KadhirTheEngineer/kaboardv3/documentation/image-2.png

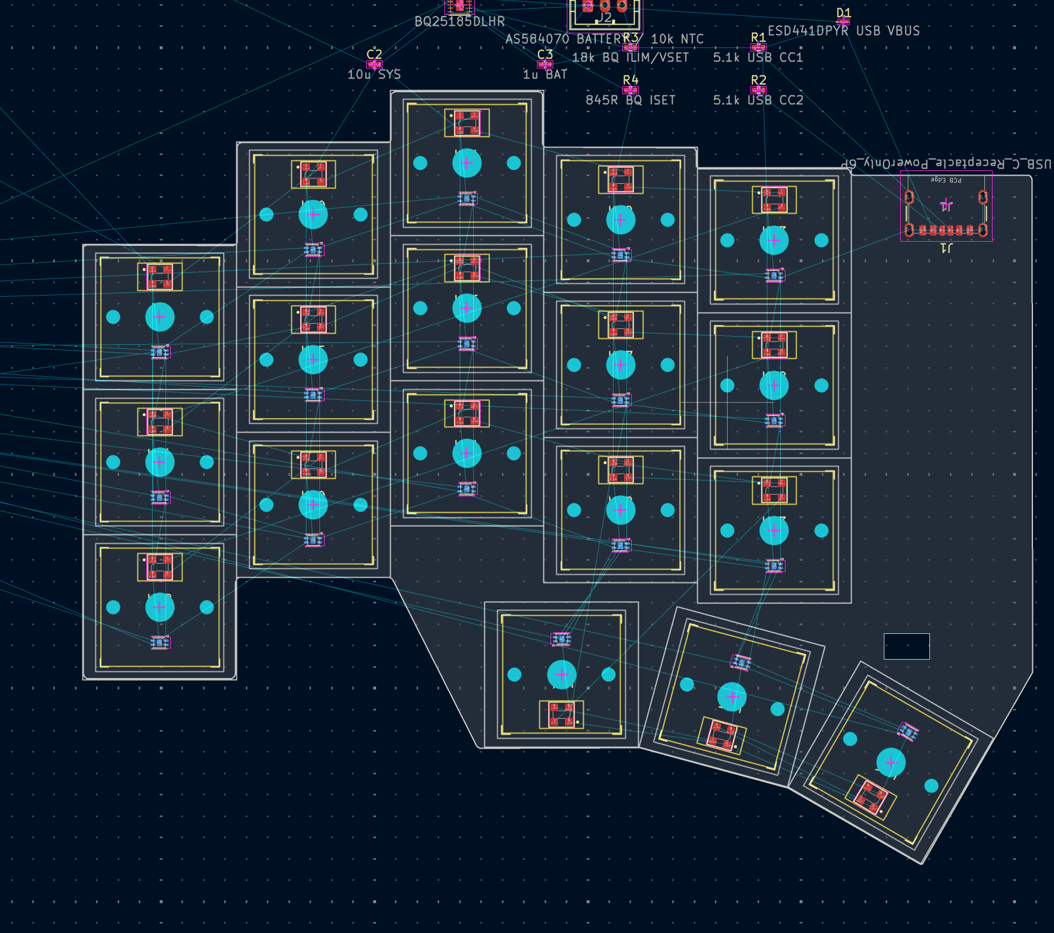
documentation/image-2.png
