KadhirTheEngineer/kaboardv3/receiver/kaboard-receiver.kicad_pcb

## KiCad design receiver/kaboard-receiver.kicad_pcb (2026-09-09)

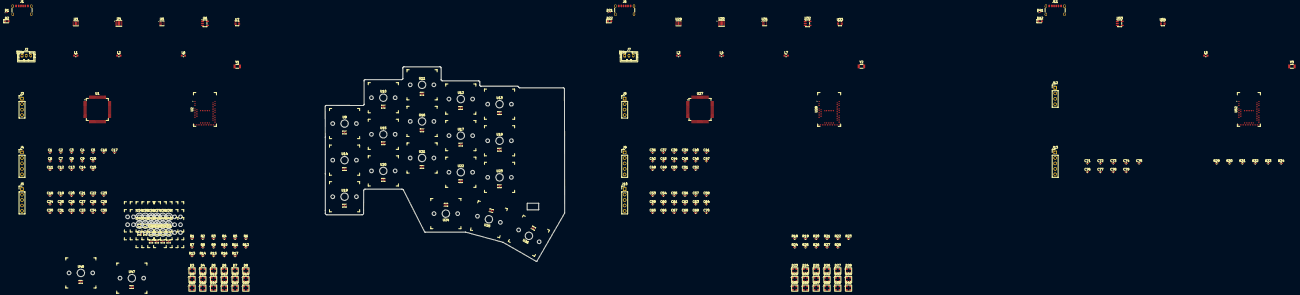
[picture p4: board kaboard-receiver.kicad_pcb from above]

Board: 2 copper layers, 231 parts (0 on the bottom side), 178 nets, no tracks yet.

Parts:
C1, C36: 1u BQ IN; C_0402_1005Metric
C2, C37: 10u SYS; C_0402_1005Metric
C3, C38: 1u BAT; C_0402_1005Metric
C4, C39: 10u TPS IN; C_0402_1005Metric
C5, C40: 10u 3V3; C_0402_1005Metric
C6, C41: 100n STM VDD; C_0402_1005Metric
C7, C42: 100n STM VDDA; C_0402_1005Metric
C8, C43, C73: 100n nRF VDD; C_0402_1005Metric
C9, C44, C74: 100n nRF VDDH; C_0402_1005Metric
C10, C45, C75: 100n nRF VBUS; C_0402_1005Metric
C11, C46, C76: 12p NRF XL1; C_0402_1005Metric
C12, C47, C77: 12p NRF XL2; C_0402_1005Metric
C13, C48: 10u RGB IN; C_0402_1005Metric
C14, C49: 47u LED 5V; C_0402_1005Metric
C15, C50: 100n LED bulk; C_0402_1005Metric
C16, C51, C78: 1u OLED VCC; C_0402_1005Metric
C17, C52, C79: 100n OLED VCC; C_0402_1005Metric
C18: 100n TMAG A01; C_0402_1005Metric
C19: 100n TMAG A02; C_0402_1005Metric
C20: 100n TMAG A03; C_0402_1005Metric
C21: 100n TMAG A04; C_0402_1005Metric
C22: 100n TMAG A05; C_0402_1005Metric
C23: 100n TMAG A06; C_0402_1005Metric
C24: 100n TMAG A07; C_0402_1005Metric
C25: 100n TMAG A08; C_0402_1005Metric
C26: 100n TMAG A09; C_0402_1005Metric
C27: 100n TMAG A10; C_0402_1005Metric
C28: 100n TMAG A11; C_0402_1005Metric
C29: 100n TMAG A12; C_0402_1005Metric
C30: 100n TMAG A13; C_0402_1005Metric
C31: 100n TMAG A14; C_0402_1005Metric
C32: 100n TMAG A15; C_0402_1005Metric
C33: 100n TMAG A16; C_0402_1005Metric
C34: 100n TMAG A17; C_0402_1005Metric
C35: 100n TMAG A18; C_0402_1005Metric
C53: 100n TMAG B01; C_0402_1005Metric
C54: 100n TMAG B02; C_0402_1005Metric
C55: 100n TMAG B03; C_0402_1005Metric
C56: 100n TMAG B04; C_0402_1005Metric
C57: 100n TMAG B05; C_0402_1005Metric
C58: 100n TMAG B06; C_0402_1005Metric
C59: 100n TMAG B07; C_0402_1005Metric
C60: 100n TMAG B08; C_0402_1005Metric
C61: 100n TMAG B09; C_0402_1005Metric
C62: 100n TMAG B10; C_0402_1005Metric
C63: 100n TMAG B11; C_0402_1005Metric
C64: 100n TMAG B12; C_0402_1005Metric
C65: 100n TMAG B13; C_0402_1005Metric
C66: 100n TMAG B14; C_0402_1005Metric
C67: 100n TMAG B15; C_0402_1005Metric
C68: 100n TMAG B16; C_0402_1005Metric
C69: 100n TMAG B17; C_0402_1005Metric
C70: 100n TMAG B18; C_0402_1005Metric
C71: 10u USB 5V IN; C_0402_1005Metric
C72: 10u RX 3V3; C_0402_1005Metric
D1, D21, D41: ESD441DPYR USB VBUS; D_0201_0603Metric
D2: LEFT STATUS LED; LED_0603_1608Metric
D3: WL-ICLED A01; U_Wurth_WL-ICLED_1312020030000
D4: WL-ICLED A02; U_Wurth_WL-ICLED_1312020030000
D5: WL-ICLED A03; U_Wurth_WL-ICLED_1312020030000
D6: WL-ICLED A04; U_Wurth_WL-ICLED_1312020030000
D7: WL-ICLED A05; U_Wurth_WL-ICLED_1312020030000
D8: WL-ICLED A06; U_Wurth_WL-ICLED_1312020030000
D9: WL-ICLED A07; U_Wurth_WL-ICLED_1312020030000
D10: WL-ICLED A08; U_Wurth_WL-ICLED_1312020030000
D11: WL-ICLED A09; U_Wurth_WL-ICLED_1312020030000
D12: WL-ICLED A10; U_Wurth_WL-ICLED_1312020030000
D13: WL-ICLED A11; U_Wurth_WL-ICLED_1312020030000
D14: WL-ICLED A12; U_Wurth_WL-ICLED_1312020030000
D15: WL-ICLED A13; U_Wurth_WL-ICLED_1312020030000
D16: WL-ICLED A14; U_Wurth_WL-ICLED_1312020030000
D17: WL-ICLED A15; U_Wurth_WL-ICLED_1312020030000
D18: WL-ICLED A16; U_Wurth_WL-ICLED_1312020030000
D19: WL-ICLED A17; U_Wurth_WL-ICLED_1312020030000
D20: WL-ICLED A18; U_Wurth_WL-ICLED_1312020030000
D22: RIGHT STATUS LED; LED_0603_1608Metric
D23: WL-ICLED B01; U_Wurth_WL-ICLED_1312020030000
D24: WL-ICLED B02; U_Wurth_WL-ICLED_1312020030000
D25: WL-ICLED B03; U_Wurth_WL-ICLED_1312020030000
D26: WL-ICLED B04; U_Wurth_WL-ICLED_1312020030000
D27: WL-ICLED B05; U_Wurth_WL-ICLED_1312020030000
D28: WL-ICLED B06; U_Wurth_WL-ICLED_1312020030000
D29: WL-ICLED B07; U_Wurth_WL-ICLED_1312020030000
D30: WL-ICLED B08; U_Wurth_WL-ICLED_1312020030000
D31: WL-ICLED B09; U_Wurth_WL-ICLED_1312020030000
D32: WL-ICLED B10; U_Wurth_WL-ICLED_1312020030000
D33: WL-ICLED B11; U_Wurth_WL-ICLED_1312020030000
D34: WL-ICLED B12; U_Wurth_WL-ICLED_1312020030000
D35: WL-ICLED B13; U_Wurth_WL-ICLED_1312020030000
D36: WL-ICLED B14; U_Wurth_WL-ICLED_1312020030000
D37: WL-ICLED B15; U_Wurth_WL-ICLED_1312020030000
D38: WL-ICLED B16; U_Wurth_WL-ICLED_1312020030000
D39: WL-ICLED B17; U_Wurth_WL-ICLED_1312020030000
D40: WL-ICLED B18; U_Wurth_WL-ICLED_1312020030000
D42: STATUS LED; LED_0603_1608Metric
J1, J6, J11: USB_C_Receptacle_PowerOnly_6P; USB_C_Receptacle_GCT_USB4125-xx-x-0190_6P_TopMnt_Horizontal
J2, J7: AS584070 BATTERY / 10k NTC; JST_PH_B3B-PH-K_1x03_P2.00mm_Vertical
J3, J8, J12: SH1106 1.3in 4-wire OLED; PinHeader_1x04_P2.54mm_Vertical
J4, J9: STM32 SWD; PinHeader_1x05_P2.54mm_Vertical
J5, J10: nRF SWD; PinHeader_1x05_P2.54mm_Vertical
J13: Receiver nRF SWD; PinHeader_1x05_P2.54mm_Vertical
L1, L3: 2.2uH TPS63031; L_0603_1608Metric
L2, L4: 1uH RGB BOOST; L_0603_1608Metric
L5, L6, L7: 10uH nRF DCDC; L_0603_1608Metric
R1, R15, R29: 5.1k USB CC1; R_0402_1005Metric
R2, R16, R30: 5.1k USB CC2; R_0402_1005Metric
R3, R17: 18k BQ ILIM/VSET; R_0402_1005Metric
R4, R18: 845R BQ ISET; R_0402_1005Metric
R5, R19, R31: 10k nRF RESET pullup; R_0402_1005Metric
R6, R20: 10k BOOT0 pulldown; R_0402_1005Metric
R7, R21, R32: 4.7k I2C SDA pullup; R_0402_1005Metric
R8, R22, R33: 4.7k I2C SCL pullup; R_0402_1005Metric
R9, R23: 1M BAT_SENSE top; R_0402_1005Metric
R10, R24: 330k BAT_SENSE bottom; R_0402_1005Metric
R11, R25: 330R RGB data; R_0402_1005Metric
R12, R26: 732k RGB FB top; R_0402_1005Metric
R13, R27: 100k RGB FB bottom; R_0402_1005Metric
R14, R28, R34: 1k STATUS LED; R_0402_1005Metric
U1, U27: STM32G431RBTx; LQFP-64_10x10mm_P0.5mm
U2, U28, U52: MDBT50Q-1MV2; Raytac_MDBT50Q
U3, U29: BQ25185DLHR; Texas_DLH0010A_WSON-10-1EP_2.2x2mm_P0.4mm_EP0.9x1.5mm
U4, U30: TPS63031DSK; WSON-10-1EP_2.5x2.5mm_P0.5mm_EP1.2x2mm
U5, U31: TPS61022 RGB BOOST; Texas_RWU0007A_VQFN-7_2x2mm_P0.5mm
U6, U32: 74AHCT1G125; SOT-23-5
U7, U33, U54: TPS22919DCK; SOT-363_SC-70-6
U9: TMAG5253 A01; Kaboard_JadePro_TMAG5253
U10: TMAG5253 A02; Kaboard_JadePro_TMAG5253
U11: TMAG5253 A03; Kaboard_JadePro_TMAG5253
U12: TMAG5253 A04; Kaboard_JadePro_TMAG5253
U13: TMAG5253 A05; Kaboard_JadePro_TMAG5253
U14: TMAG5253 A06; Kaboard_JadePro_TMAG5253
U15: TMAG5253 A07; Kaboard_JadePro_TMAG5253
U16: TMAG5253 A08; Kaboard_JadePro_TMAG5253
U17: TMAG5253 A09; Kaboard_JadePro_TMAG5253
U18: TMAG5253 A10; Kaboard_JadePro_TMAG5253
U19: TMAG5253 A11; Kaboard_JadePro_TMAG5253
U20: TMAG5253 A12; Kaboard_JadePro_TMAG5253
U21: TMAG5253 A13; Kaboard_JadePro_TMAG5253
U22: TMAG5253 A14; Kaboard_JadePro_TMAG5253
U23: TMAG5253 A15; Kaboard_JadePro_TMAG5253
U24: TMAG5253 A16; Kaboard_JadePro_TMAG5253
U25: TMAG5253 A17; Kaboard_JadePro_TMAG5253
U26: TMAG5253 A18; Kaboard_JadePro_TMAG5253
U34: TMAG5253 B01; Kaboard_JadePro_TMAG5253
U35: TMAG5253 B02; Kaboard_JadePro_TMAG5253
U36: TMAG5253 B03; Kaboard_JadePro_TMAG5253
U37: TMAG5253 B04; Kaboard_JadePro_TMAG5253
U38: TMAG5253 B05; Kaboard_JadePro_TMAG5253
U39: TMAG5253 B06; Kaboard_JadePro_TMAG5253
U40: TMAG5253 B07; Kaboard_JadePro_TMAG5253
U41: TMAG5253 B08; Kaboard_JadePro_TMAG5253
U42: TMAG5253 B09; Kaboard_JadePro_TMAG5253
U43: TMAG5253 B10; Kaboard_JadePro_TMAG5253
U44: TMAG5253 B11; Kaboard_JadePro_TMAG5253
U45: TMAG5253 B12; Kaboard_JadePro_TMAG5253
U46: TMAG5253 B13; Kaboard_JadePro_TMAG5253
U47: TMAG5253 B14; Kaboard_JadePro_TMAG5253
U48: TMAG5253 B15; Kaboard_JadePro_TMAG5253
U49: TMAG5253 B16; Kaboard_JadePro_TMAG5253
U50: TMAG5253 B17; Kaboard_JadePro_TMAG5253
U51: TMAG5253 B18; Kaboard_JadePro_TMAG5253
U53: AP2112K-3.3; SOT-23-5
Y1, Y2, Y3: 32.768kHz; Crystal_SMD_3215-2Pin_3.2x1.5mm

Connections:
/L_3V3: C5.1, C6.1, C7.1, C8.1, C9.1, C10.1, C13.1, C18.1, C19.1, C20.1, C21.1, C22.1, C23.1, C24.1, C25.1, C26.1, C27.1, C28.1, C29.1, C30.1, C31.1, C32.1, C33.1, C34.1, C35.1, J4.1, J5.1, L2.1, L6.2, R5.2, R7.1, R8.1, U1.1 (VBAT), U1.16 (VDD), U1.28 (VREF+), U1.29 (VDDA), U1.32 (VDD), U1.48 (VDD), U1.64 (VDD), U2.28 (VDD), U2.30 (VDDH), U2.32 (VBUS), U4.1 (VOUT), U4.10 (FB), U5.7 (VIN), U7.1 (IN), U9.1 (VCC), U10.1 (VCC), U11.1 (VCC), U12.1 (VCC), U13.1 (VCC), U14.1 (VCC), U15.1 (VCC), U16.1 (VCC), U17.1 (VCC), U18.1 (VCC), U19.1 (VCC), U20.1 (VCC), U21.1 (VCC), U22.1 (VCC), U23.1 (VCC), U24.1 (VCC), U25.1 (VCC), U26.1 (VCC)
/L_BAT: C3.1, J2.1, R9.1, U3.2 (BAT)
/L_BAT_SENSE: R9.2, R10.1, U2.10 (P0.29)
/L_BOOT0: R6.1, U1.61 (PB8)
/L_BQ_ILIM: R3.1, U3.7 (ILIM/VSET)
/L_BQ_ISET: R4.1, U3.8 (ISET)
/L_DISPLAY_EN: U2.49 (P0.25), U7.3 (ON)
/L_DISPLAY_SCL: J3.3, R8.2, U2.19 (P0.26)
/L_DISPLAY_SDA: J3.4, R7.2, U2.16 (P0.27)
/L_GND: C1.2, C2.2, C3.2, C4.2, C5.2, C6.2, C7.2, C8.2, C9.2, C10.2, C11.2, C12.2, C13.2, C14.2, C15.2, C16.2, C17.2, C18.2, C19.2, C20.2, C21.2, C22.2, C23.2, C24.2, C25.2, C26.2, C27.2, C28.2, C29.2, C30.2, C31.2, C32.2, C33.2, C34.2, C35.2, D1.2 (GND), D2.1 (K), D3.4 (VSS), D4.4 (VSS), D5.4 (VSS), D6.4 (VSS), D7.4 (VSS), D8.4 (VSS), D9.4 (VSS), D10.4 (VSS), D11.4 (VSS), D12.4 (VSS), D13.4 (VSS), D14.4 (VSS), D15.4 (VSS), D16.4 (VSS), D17.4 (VSS), D18.4 (VSS), D19.4 (VSS), D20.4 (VSS), J1.A12 (GND), J1.B12 (GND), J1.SH (SHIELD), J2.3, J3.2, J4.2, J5.2, R1.2, R2.2, R3.2, R4.2, R6.2, R10.2, R13.2, U1.15 (VSS), U1.27 (VSSA), U1.31 (VSS), U1.47 (VSS), U1.63 (VSS), U2.1 (GND), U2.2 (GND), U2.15 (GND), U2.33 (GND), U2.55 (GND), U3.4 (/CE), U3.5 (GND), U3.11 (EP), U4.3 (PGND), U4.7 (PS/SYNC), U4.9 (GND), U4.11 (PGND), U5.1 (GND), U5.6 (MODE), U6.1, U6.3 (GND), U7.2 (GND), U9.2 (GND), U9.5 (EP), U10.2 (GND), U10.5 (EP), U11.2 (GND), U11.5 (EP), U12.2 (GND), U12.5 (EP), U13.2 (GND), U13.5 (EP), U14.2 (GND), U14.5 (EP), U15.2 (GND), U15.5 (EP), U16.2 (GND), U16.5 (EP), U17.2 (GND), U17.5 (EP), U18.2 (GND), U18.5 (EP), U19.2 (GND), U19.5 (EP), U20.2 (GND), U20.5 (EP), U21.2 (GND), U21.5 (EP), U22.2 (GND), U22.5 (EP), U23.2 (GND), U23.5 (EP), U24.2 (GND), U24.5 (EP), U25.2 (GND), U25.5 (EP), U26.2 (GND), U26.5 (EP)
/L_HALL_EN_A: U1.38 (PC6), U9.3 (EN), U10.3 (EN), U11.3 (EN), U12.3 (EN), U13.3 (EN), U14.3 (EN)
/L_HALL_EN_B: U1.39 (PC7), U15.3 (EN), U16.3 (EN), U17.3 (EN), U18.3 (EN), U19.3 (EN), U20.3 (EN)
/L_HALL_EN_C: U1.40 (PC8), U21.3 (EN), U22.3 (EN), U23.3 (EN), U24.3 (EN), U25.3 (EN), U26.3 (EN)
/L_HALL_OUT_01: U1.8 (PC0), U9.4 (OUT)
/L_HALL_OUT_02: U1.9 (PC1), U10.4 (OUT)
/L_HALL_OUT_03: U1.10 (PC2), U11.4 (OUT)
/L_HALL_OUT_04: U1.11 (PC3), U12.4 (OUT)
/L_HALL_OUT_05: U1.12 (PA0), U13.4 (OUT)
/L_HALL_OUT_06: U1.13 (PA1), U14.4 (OUT)
/L_HALL_OUT_07: U1.14 (PA2), U15.4 (OUT)
/L_HALL_OUT_08: U1.17 (PA3), U16.4 (OUT)
/L_HALL_OUT_09: U1.18 (PA4), U17.4 (OUT)
/L_HALL_OUT_10: U1.19 (PA5), U18.4 (OUT)
/L_HALL_OUT_11: U1.20 (PA6), U19.4 (OUT)
/L_HALL_OUT_12: U1.21 (PA7), U20.4 (OUT)
/L_HALL_OUT_13: U1.22 (PC4), U21.4 (OUT)
/L_HALL_OUT_14: U1.23 (PC5), U22.4 (OUT)
/L_HALL_OUT_15: U1.24 (PB0), U23.4 (OUT)
/L_HALL_OUT_16: U1.25 (PB1), U24.4 (OUT)
/L_HALL_OUT_17: U1.26 (PB2), U25.4 (OUT)
/L_HALL_OUT_18: U1.33 (PB11), U26.4 (OUT)
/L_LED_5V: C14.1, C15.1, D3.1 (VDD), D4.1 (VDD), D5.1 (VDD), D6.1 (VDD), D7.1 (VDD), D8.1 (VDD), D9.1 (VDD), D10.1 (VDD), D11.1 (VDD), D12.1 (VDD), D13.1 (VDD), D14.1 (VDD), D15.1 (VDD), D16.1 (VDD), D17.1 (VDD), D18.1 (VDD), D19.1 (VDD), D20.1 (VDD), R12.1, U5.3 (VOUT), U5.4 (FB), U6.5 (VCC)
/L_NRF_DCCH: L6.1, U2.31 (DCCH)
/L_NRF_RESET_N: J5.5, R5.1, U2.40 (P0.18)
/L_NRF_XL1: C11.1, U2.17 (P0.00), Y1.1
/L_NRF_XL2: C12.1, U2.18 (P0.01), Y1.2
/L_NTC: J2.2, U3.6 (TS/MR)
/L_OLED_VCC: C16.1, C17.1, J3.1, U7.6 (OUT)
/L_RGB_DATA_3V3: U1.42 (PA8), U6.2
/L_RGB_DATA_5V: R11.1, U6.4
/L_RGB_DIN_01: D3.2 (DIN), R11.2
/L_RGB_DIN_07: D8.3 (DOUT), D9.2 (DIN)
/L_RGB_DIN_13: D14.3 (DOUT), D15.2 (DIN)
/L_RGB_FB: R12.2, R13.1
/L_RGB_PWR_EN: U1.43 (PA9), U5.5 (EN)
/L_RGB_SW: L2.2, U5.2 (SW)
/L_SPI_CS_N: U1.51 (PA15), U2.44 (P0.20)
/L_SPI_MISO: U1.53 (PC11), U2.46 (P0.22)
/L_SPI_MOSI: U1.54 (PC12), U2.43 (P0.21)
/L_SPI_SCK: U1.52 (PC10), U2.42 (P0.19)
/L_STATUS_LED: R14.1, U2.48 (P0.24)
/L_STATUS_LED_A: D2.2 (A), R14.2
/L_STM_DATA_READY: U1.30 (PB10), U2.36 (P0.14)
/L_STM_RESET_N: J4.5, U1.7 (PG10)
/L_STM_WAKE_NRF: U1.41 (PC9), U2.37 (P0.13)
/L_SWCLK_NRF: J5.4, U2.53 (SWDCLK)
/L_SWCLK_STM: J4.4, U1.50 (PA14)
/L_SWDIO_NRF: J5.3, U2.51 (SWDIO)
/L_SWDIO_STM: J4.3, U1.49 (PA13)
/L_SYS: C2.1, C4.1, U3.1 (SYS), U4.5 (VIN), U4.6 (EN), U4.8 (VINA)
/L_TPS_L1: L1.1, U4.4 (L1)
/L_TPS_L2: L1.2, U4.2 (L2)
/L_USB_CC1: J1.A5 (CC1), R1.1
/L_USB_CC2: J1.B5 (CC2), R2.1
/L_USB_VBUS: C1.1, D1.1 (IO), J1.A9 (VBUS), J1.B9 (VBUS), U3.10 (IN)
/RX_3V3: C72.1, C73.1, C74.1, C75.1, J13.1, L5.2, R31.2, R32.1, R33.1, U52.28 (VDD), U52.30 (VDDH), U52.32 (VBUS), U53.5 (VOUT), U54.1 (IN)
/RX_DISPLAY_EN: U52.49 (P0.25), U54.3 (ON)
/RX_DISPLAY_SCL: J12.3, R33.2, U52.19 (P0.26)
/RX_DISPLAY_SDA: J12.4, R32.2, U52.16 (P0.27)
/RX_GND: C71.2, C72.2, C73.2, C74.2, C75.2, C76.2, C77.2, C78.2, C79.2, D41.2 (GND), D42.1 (K), J11.A12 (GND), J11.B12 (GND), J11.SH (SHIELD), J12.2, J13.2, R29.2, R30.2, U52.1 (GND), U52.2 (GND), U52.15 (GND), U52.33 (GND), U52.55 (GND), U53.2 (GND), U54.2 (GND)
/RX_NRF_DCCH: L5.1, U52.31 (DCCH)
/RX_NRF_RESET_N: J13.5, R31.1, U52.40 (P0.18)
/RX_NRF_XL1: C76.1, U52.17 (P0.00), Y3.1
/RX_NRF_XL2: C77.1, U52.18 (P0.01), Y3.2
/RX_OLED_VCC: C78.1, C79.1
/RX_STATUS_LED: R34.1, U52.48 (P0.24)
/RX_STATUS_LED_A: D42.2 (A), R34.2
/RX_SWCLK: J13.4, U52.53 (SWDCLK)
/RX_SWDIO: J13.3, U52.51 (SWDIO)
/RX_USB_CC1: J11.A5 (CC1), R29.1
/RX_USB_CC2: J11.B5 (CC2), R30.1
/RX_USB_VBUS: C71.1, D41.1 (IO), J11.A9 (VBUS), J11.B9 (VBUS), U53.1 (VIN), U53.3 (EN)
/R_3V3: C40.1, C41.1, C42.1, C43.1, C44.1, C45.1, C48.1, C53.1, C54.1, C55.1, C56.1, C57.1, C58.1, C59.1, C60.1, C61.1, C62.1, C63.1, C64.1, C65.1, C66.1, C67.1, C68.1, C69.1, C70.1, J9.1, J10.1, L4.1, L7.2, R19.2, R21.1, R22.1, U27.1 (VBAT), U27.16 (VDD), U27.28 (VREF+), U27.29 (VDDA), U27.32 (VDD), U27.48 (VDD), U27.64 (VDD), U28.28 (VDD), U28.30 (VDDH), U28.32 (VBUS), U30.1 (VOUT), U30.10 (FB), U31.7 (VIN), U33.1 (IN), U34.1 (VCC), U35.1 (VCC), U36.1 (VCC), U37.1 (VCC), U38.1 (VCC), U39.1 (VCC), U40.1 (VCC), U41.1 (VCC), U42.1 (VCC), U43.1 (VCC), U44.1 (VCC), U45.1 (VCC), U46.1 (VCC), U47.1 (VCC), U48.1 (VCC), U49.1 (VCC), U50.1 (VCC), U51.1 (VCC)
/R_BAT: C38.1, J7.1, R23.1, U29.2 (BAT)
/R_BAT_SENSE: R23.2, R24.1, U28.10 (P0.29)
/R_BOOT0: R20.1, U27.61 (PB8)
/R_BQ_ILIM: R17.1, U29.7 (ILIM/VSET)
/R_BQ_ISET: R18.1, U29.8 (ISET)
/R_DISPLAY_EN: U28.49 (P0.25), U33.3 (ON)
/R_DISPLAY_SCL: J8.3, R22.2, U28.19 (P0.26)
/R_DISPLAY_SDA: J8.4, R21.2, U28.16 (P0.27)
/R_GND: C36.2, C37.2, C38.2, C39.2, C40.2, C41.2, C42.2, C43.2, C44.2, C45.2, C46.2, C47.2, C48.2, C49.2, C50.2, C51.2, C52.2, C53.2, C54.2, C55.2, C56.2, C57.2, C58.2, C59.2, C60.2, C61.2, C62.2, C63.2, C64.2, C65.2, C66.2, C67.2, C68.2, C69.2, C70.2, D21.2 (GND), D22.1 (K), D23.4 (VSS), D24.4 (VSS), D25.4 (VSS), D26.4 (VSS), D27.4 (VSS), D28.4 (VSS), D29.4 (VSS), D30.4 (VSS), D31.4 (VSS), D32.4 (VSS), D33.4 (VSS), D34.4 (VSS), D35.4 (VSS), D36.4 (VSS), D37.4 (VSS), D38.4 (VSS), D39.4 (VSS), D40.4 (VSS), J6.A12 (GND), J6.B12 (GND), J6.SH (SHIELD), J7.3, J8.2, J9.2, J10.2, R15.2, R16.2, R17.2, R18.2, R20.2, R24.2, R27.2, U27.15 (VSS), U27.27 (VSSA), U27.31 (VSS), U27.47 (VSS), U27.63 (VSS), U28.1 (GND), U28.2 (GND), U28.15 (GND), U28.33 (GND), U28.55 (GND), U29.4 (/CE), U29.5 (GND), U29.11 (EP), U30.3 (PGND), U30.7 (PS/SYNC), U30.9 (GND), U30.11 (PGND), U31.1 (GND), U31.6 (MODE), U32.1, U32.3 (GND), U33.2 (GND), U34.2 (GND), U34.5 (EP), U35.2 (GND), U35.5 (EP), U36.2 (GND), U36.5 (EP), U37.2 (GND), U37.5 (EP), U38.2 (GND), U38.5 (EP), U39.2 (GND), U39.5 (EP), U40.2 (GND), U40.5 (EP), U41.2 (GND), U41.5 (EP), U42.2 (GND), U42.5 (EP), U43.2 (GND), U43.5 (EP), U44.2 (GND), U44.5 (EP), U45.2 (GND), U45.5 (EP), U46.2 (GND), U46.5 (EP), U47.2 (GND), U47.5 (EP), U48.2 (GND), U48.5 (EP), U49.2 (GND), U49.5 (EP), U50.2 (GND), U50.5 (EP), U51.2 (GND), U51.5 (EP)
/R_HALL_EN_A: U27.38 (PC6), U34.3 (EN), U35.3 (EN), U36.3 (EN), U37.3 (EN), U38.3 (EN), U39.3 (EN)
/R_HALL_EN_B: U27.39 (PC7), U40.3 (EN), U41.3 (EN), U42.3 (EN), U43.3 (EN), U44.3 (EN), U45.3 (EN)
/R_HALL_EN_C: U27.40 (PC8), U46.3 (EN), U47.3 (EN), U48.3 (EN), U49.3 (EN), U50.3 (EN), U51.3 (EN)
/R_HALL_OUT_01: U27.8 (PC0), U34.4 (OUT)
/R_HALL_OUT_02: U27.9 (PC1), U35.4 (OUT)
/R_HALL_OUT_03: U27.10 (PC2), U36.4 (OUT)
/R_HALL_OUT_04: U27.11 (PC3), U37.4 (OUT)
/R_HALL_OUT_05: U27.12 (PA0), U38.4 (OUT)
/R_HALL_OUT_06: U27.13 (PA1), U39.4 (OUT)
/R_HALL_OUT_07: U27.14 (PA2), U40.4 (OUT)
/R_HALL_OUT_08: U27.17 (PA3), U41.4 (OUT)
/R_HALL_OUT_09: U27.18 (PA4), U42.4 (OUT)
/R_HALL_OUT_10: U27.19 (PA5), U43.4 (OUT)
/R_HALL_OUT_11: U27.20 (PA6), U44.4 (OUT)
/R_HALL_OUT_12: U27.21 (PA7), U45.4 (OUT)
/R_HALL_OUT_13: U27.22 (PC4), U46.4 (OUT)
/R_HALL_OUT_14: U27.23 (PC5), U47.4 (OUT)
/R_HALL_OUT_15: U27.24 (PB0), U48.4 (OUT)
/R_HALL_OUT_16: U27.25 (PB1), U49.4 (OUT)
/R_HALL_OUT_17: U27.26 (PB2), U50.4 (OUT)
/R_HALL_OUT_18: U27.33 (PB11), U51.4 (OUT)
/R_LED_5V: C49.1, C50.1, D23.1 (VDD), D24.1 (VDD), D25.1 (VDD), D26.1 (VDD), D27.1 (VDD), D28.1 (VDD), D29.1 (VDD), D30.1 (VDD), D31.1 (VDD), D32.1 (VDD), D33.1 (VDD), D34.1 (VDD), D35.1 (VDD), D36.1 (VDD), D37.1 (VDD), D38.1 (VDD), D39.1 (VDD), D40.1 (VDD), R26.1, U31.3 (VOUT), U31.4 (FB), U32.5 (VCC)
/R_NRF_DCCH: L7.1, U28.31 (DCCH)
/R_NRF_RESET_N: J10.5, R19.1, U28.40 (P0.18)
/R_NRF_XL1: C46.1, U28.17 (P0.00), Y2.1
/R_NRF_XL2: C47.1, U28.18 (P0.01), Y2.2
/R_NTC: J7.2, U29.6 (TS/MR)
/R_OLED_VCC: C51.1, C52.1, J8.1, U33.6 (OUT)
/R_RGB_DATA_3V3: U27.42 (PA8), U32.2
/R_RGB_DATA_5V: R25.1, U32.4
/R_RGB_DIN_01: D23.2 (DIN), R25.2
/R_RGB_DIN_07: D28.3 (DOUT), D29.2 (DIN)
/R_RGB_DIN_13: D34.3 (DOUT), D35.2 (DIN)
/R_RGB_FB: R26.2, R27.1
/R_RGB_PWR_EN: U27.43 (PA9), U31.5 (EN)
/R_RGB_SW: L4.2, U31.2 (SW)
/R_SPI_CS_N: U27.51 (PA15), U28.44 (P0.20)
/R_SPI_MISO: U27.53 (PC11), U28.46 (P0.22)
/R_SPI_MOSI: U27.54 (PC12), U28.43 (P0.21)
/R_SPI_SCK: U27.52 (PC10), U28.42 (P0.19)
/R_STATUS_LED: R28.1, U28.48 (P0.24)
/R_STATUS_LED_A: D22.2 (A), R28.2
/R_STM_DATA_READY: U27.30 (PB10), U28.36 (P0.14)
/R_STM_RESET_N: J9.5, U27.7 (PG10)
/R_STM_WAKE_NRF: U27.41 (PC9), U28.37 (P0.13)
/R_SWCLK_NRF: J10.4, U28.53 (SWDCLK)
/R_SWCLK_STM: J9.4, U27.50 (PA14)
/R_SWDIO_NRF: J10.3, U28.51 (SWDIO)
/R_SWDIO_STM: J9.3, U27.49 (PA13)
/R_SYS: C37.1, C39.1, U29.1 (SYS), U30.5 (VIN), U30.6 (EN), U30.8 (VINA)
/R_TPS_L1: L3.1, U30.4 (L1)
/R_TPS_L2: L3.2, U30.2 (L2)
/R_USB_CC1: J6.A5 (CC1), R15.1
/R_USB_CC2: J6.B5 (CC2), R16.1
/R_USB_VBUS: C36.1, D21.1 (IO), J6.A9 (VBUS), J6.B9 (VBUS), U29.10 (IN)
unnamed: D3.3 (DOUT), D4.2 (DIN)
unnamed: D4.3 (DOUT), D5.2 (DIN)
unnamed: D5.3 (DOUT), D6.2 (DIN)
unnamed: D6.3 (DOUT), D7.2 (DIN)
unnamed: D7.3 (DOUT), D8.2 (DIN)
unnamed: D9.3 (DOUT), D10.2 (DIN)
unnamed: D10.3 (DOUT), D11.2 (DIN)
unnamed: D11.3 (DOUT), D12.2 (DIN)
unnamed: D12.3 (DOUT), D13.2 (DIN)
unnamed: D13.3 (DOUT), D14.2 (DIN)
unnamed: D15.3 (DOUT), D16.2 (DIN)
unnamed: D16.3 (DOUT), D17.2 (DIN)
unnamed: D17.3 (DOUT), D18.2 (DIN)
unnamed: D18.3 (DOUT), D19.2 (DIN)
unnamed: D19.3 (DOUT), D20.2 (DIN)
unnamed: D23.3 (DOUT), D24.2 (DIN)
unnamed: D24.3 (DOUT), D25.2 (DIN)
unnamed: D25.3 (DOUT), D26.2 (DIN)
unnamed: D26.3 (DOUT), D27.2 (DIN)
unnamed: D27.3 (DOUT), D28.2 (DIN)
unnamed: D29.3 (DOUT), D30.2 (DIN)
unnamed: D30.3 (DOUT), D31.2 (DIN)
unnamed: D31.3 (DOUT), D32.2 (DIN)
unnamed: D32.3 (DOUT), D33.2 (DIN)
unnamed: D33.3 (DOUT), D34.2 (DIN)
unnamed: D35.3 (DOUT), D36.2 (DIN)
unnamed: D36.3 (DOUT), D37.2 (DIN)
unnamed: D37.3 (DOUT), D38.2 (DIN)
unnamed: D38.3 (DOUT), D39.2 (DIN)
unnamed: D39.3 (DOUT), D40.2 (DIN)
unnamed: J12.1, U54.6 (OUT)
