KadhirTheEngineer/kaboardv3/(commit log)

2026-09-07 Initialize Kaboard V3 project
    [kaboardv3-hw.kicad_pcb, kaboardv3-hw.kicad_sch]
2026-09-07 capture validated keyboard electrical baseline
    [kaboardv3-hw.kicad_sch]
2026-09-07 organize schematic into readable functional sections
    [kaboardv3-hw.kicad_sch]
2026-09-07 wire local schematic blocks for readability
    [kaboardv3-hw.kicad_sch]
2026-09-07 wire receiver OLED power path
    [kaboardv3-hw.kicad_sch]
2026-09-09 Finalize split board layout and documentation
    [kaboard-left.kicad_pcb, kaboard-left.kicad_sch, kaboard-receiver.kicad_pcb, kaboard-receiver.kicad_sch, kaboard-right.kicad_pcb, kaboard-right.kicad_sch, kaboardv3-hw.kicad_sch]
2026-09-09 organize unified schematics
    [kaboard-receiver.kicad_sch, kaboard-right.kicad_sch, kaboardv3-hw.kicad_sch, left.kicad_sch, right-half.kicad_sch, usb-receiver.kicad_sch]
